fvgm/FM_kicad_libs/README.md

My personal repository of KiCad 7 symbols, footprints and 3d models.
