fvgm/FM_kicad_libs/(list of files, cad)

Other CAD files:
3d_models/black_pill.wrl.sldprt
