fvgm/FM_kicad_libs/(commit log)

2024-04-23 Added: FM-Connector_USB
2024-08-21 Added: FM-Boards
    RFID-RC522 module
2024-10-09 FM-Package_QFP footprint library added.
2024-10-09 FM-Microcontrollers changed to use local footprint for STM32F103C8Tx .
2024-10-10 FM-Crystal footprint library added.
2024-10-10 FM-Regulators library added.
2024-10-10 SOT-23-5 package added to FM-Package_TO_SOT_SMD footprint library.
2024-10-11 Q_PMOS_GSD symbol added to FM-MOSFET library.
2024-10-11 Conn_01x01 symbol added to FM-Connectors library.
2024-11-08 W25Q16 and ADS1115 added to FM-Integrated Circuits
2024-11-08 MAX3485 added to FM-Integrated Circuits
2024-11-10 JST SH2 Connectors Added
2024-11-16 Added Reed PTH footprint
2024-11-19 P6SMB6.8CA TVS diode added + footprints.
2025-02-28 "Conn_02x04_Odd_Even" added to "FM-Connectors" library.
2025-03-01 "SMAJ12CA" added to "FM-Diodes" library.
2025-03-01 "AT24C32N" added to "FM-Integrated Circuits" library.
2025-03-01 Footprint set for "DMX-26S" at "FM-Crystals".
2025-03-01 Added 3D Model for CT-07 footprint.
2025-03-01 Updated 3D Model path for D_SMA.kicad_mod
2025-03-01 Updated 3D Model for Crystal_SMD_SeikoEpson_MC306-4Pin_8.0x3.2mm
2025-03-03 Battery_Positive_Terminal added to "FM-Misc"
2025-03-03 3D Model added to "PinSocket_1x04_P2.54mm_Vertical" footprint.
2025-03-03 Added battery circle diameter to Battery_Positive_Terminal
2025-03-04 1.00mm PinHeader library created.
2025-03-14 "TestPoint" symbol added to "FM-Connectors" library.
2025-03-29 "TestPoint_Pad_1.0x1.0mm" added to "FM-TestPoints" library.
2025-03-29 "TestPoint_Pad_D1.0mm" added to "FM-TestPoints" library.
2025-04-19 Added a 3D model to "Spring_To_PCB'.
2025-05-08 Added "Spring_To_PCB_Terminal_2.kicad_mod" to "FM-Misc" library.
2025-05-09 Removed 3d Model from "Spring_To_PCB_Terminal_2"
2025-05-11 Reed_14mm_2mm_PTH.kicad_mod footprint updated
2025-05-12 Updated 3D model for Reed_14mm_2mm_PTH.kicad_mod
2025-06-10 "Spring_To_PCB_Terminal_6mm_Radius.kicad_mod" created at "FM-Misc" library.
2025-06-14 MiniMELF diode added.
2025-06-14 D_MiniMELF.kicad_mod added to FM-Diode-SMD library.
2025-06-14 Battery_Positive_Terminal.kicad_mod updated.
2025-06-14 Added SOD-323 diode package.
2025-10-05 "ESP32-H2-MINI-1" symbol, footprint and 3D model added.
2025-10-05 "Fuse Small" added to "FM-Devices" library.
2025-10-20 ESP32-H2-MINI-1 module: The property "Value" from symbol was set to hidden.
2025-10-25 Conn_01x09 addded to "FM-Connectors.kicad_sym" sybol library.
2025-10-25 Conn_01x07 added to "FM-Connectors.kicad_sym" library.
2025-10-26 BAT54C Added to "FM-Diodes.kicad_sym"; 3D models copied to repository.
2025-10-30 S8050 added to "FM-Transistor_BJT.kicad_sym" library.
2025-10-30 "FM-Connector_Board_Edge.pretty/Board_Edge_1x07_P2.54mm_Perpendicular.kicad_mod" library created.
2025-11-01 BSS138 added to "FM-MOSFET.kicad_sym" library.
2025-11-05 "Board_Edge_1x07_P2.54mm_Perpendicular" changed to solid pads.
2025-11-05 "FM-Opto.kicad_sym" library created for SMD leds and related components.
2025-11-13 Added the vertical ESP32-H2-CPU_MODULE.
2025-11-22 SMD LED 0603 added to "FM-Opto" library.
2026-01-23 FM-Modules:ESP32-H2-CPU_MODULE_VERTICAL footprint updated to easily identify first and last pin.
2026-01-23 FM-Modules:ESP32-H2-CPU-MODULE pins flipped to the correct position
2026-02-13 L7805 symbol added to FM-Regulators.kicad_sym library.
2026-02-13 PIC16F88-IP/SO symbol added to FM-Microcontrollers.kicad_sym library.
2026-02-14 FM-Real_Time_Clock.kicad_sym library created. DS3231M added.
2026-02-14 TSOP1838 added to new FM-Opto.kicad_sym library.
2026-02-22 788AS footprint and model created.
2026-02-25 BC847 added to "FM-Transistor_BJT.kicad_sym" library.
2026-03-06 New library FM-Connector_Barrel_Jack created.
2026-03-26 TO-220_3 Horizontal with HeatSink added.
2026-03-31 TO-220-3_Horizontal_TabDown_HeatSink.kicad_mod updated.
2026-03-31 FM-Symbols PCB added.
2026-04-10 Angled Electrolytic Capacitors: Silkscreen fixed
2026-04-10 FM-Capacitor_Tantalum_SMD.pretty added.
2026-04-10 Tantalum SMD Capacitors - 3D Model references updated.
2026-11-13 PY32F003F18P6TR pin layout updated.
